martinhol221/M590_autostart_car_engine/(list of files, drawings)

Other design files:
autortart_M590.lay6
autortart_M5901.5.lay6
other/autortart_M590.lay6
