martinhol221/M590_autostart_car_engine/(commit log)

2017-05-15 Create M590_Autostart_engine.ino
    Скетч для автозапуска двигателя
2017-05-26 Скетч для ардуино
2017-05-30 разводка печатной платы
    [autortart_M590.lay6]
2017-05-31 Принципиальная электрическая схема
2017-06-23 Скетч для управления по GSM реле Вебасто
2017-06-25 Добавлен контроль запуска по давлению масла
2017-06-25 Обновленная версия платы
    [autortart_M5901.5.lay6]
2017-06-25 Обновленная плата для Sprint-Layout
    Sprint-Layout
    [autortart_M590.lay6]
2017-06-27 Обновленная плата для Sprint-Layout
    [autortart_M590.lay6]
2017-06-27 Шаблон для производства платы ЛУТом
2017-06-27 Фотошаблон для производства платы фоторезистом (нега
2017-06-27 Расположение элементов на плате
2017-07-03 Исправлен косяк с реакцией на все номера
2017-10-31 полностью обновленный скетч
2017-11-05 исходники старой платы
    [autortart_M590.lay6]
2017-11-05 принципиальная схема
2017-12-26 Последний счкетч 1,7
2017-12-29 Схема подключения
2017-12-29 график напряжения
